DeanSupertramp/Progettazione_Industriale/README.md

# *_Dispositivo per il monitoraggio indoor della qualità ambientale e inoltro dati tramite SMS_*
### Corso di Laurea Magistrale in Ingegneria Elettronica, Corso di Progettazione Industriale, Unical, aa 2020/2021
Il progetto prevede la realizzazione di un dispositivo smart adatto per contesti abitativi, uffici, ospedali, palestre, trasporti, scuole, per monitorare la qualità dell’aria interna e in generale dei parametri ambientali ad esso associata.
Il sistema è basato su diversi sensori e sistemi di notifica (visivo e uditivo, locale e in remoto). Altra funzionalità implementata è la notifica da remoto dello stato ambientale tramite SMS, riportando anche l’eventuale assenza di corrente nella rete elettrica domestica.

## Indice
1. [Schema a blocchi del sistema](#schema-a-blocchi-del-sistema)
2. [Prototipo](#prototipo)
3. [Render 3D del dispositivo](#render-3d-del-dispositivo)
4. [Relazione Tecnica](https://github.com/DeanSupertramp/Progettazione_Industriale/blob/master/Report%20Finale%20Progetto%20-%20Andrea%20Alecce.pdf)
5. [Presentazione](https://github.com/DeanSupertramp/Progettazione_Industriale/blob/master/Presentazione%20Finale%20Progetto%20-%20Andrea%20Alecce.pdf)

## Schema a blocchi del sistema
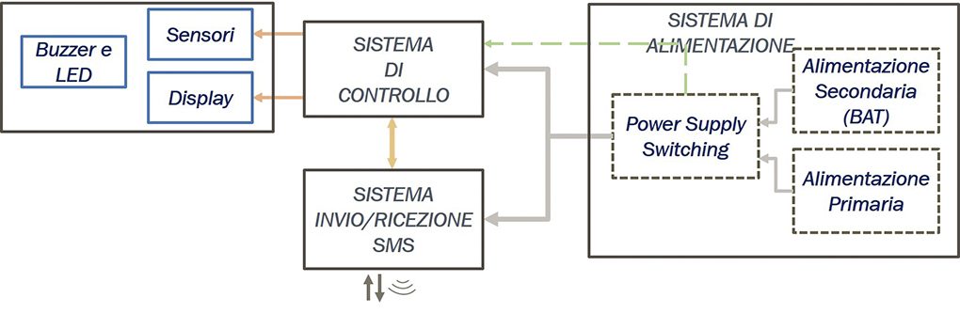
[picture p1: images/blockdiagram.jpg]


## Prototipo
<p align="center">
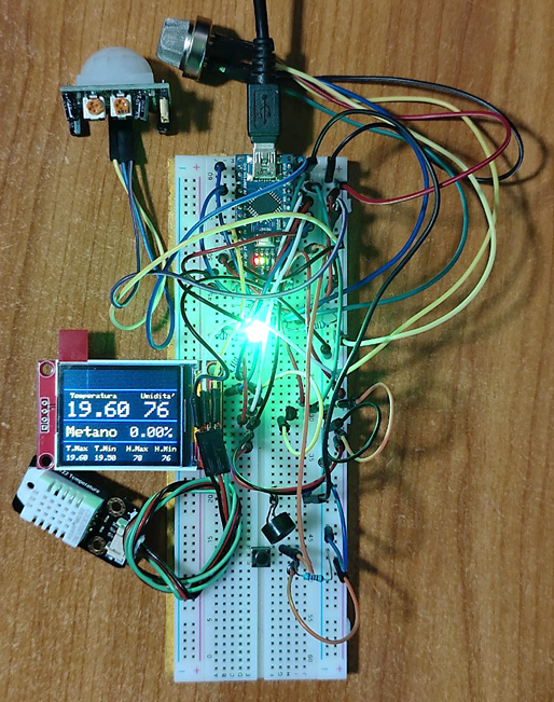
[picture p2: images/prototipo.png]

</p>

## Render 3D del dispositivo
<p align="center">
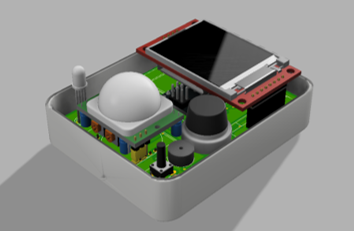
[picture p3: images/render1.png]

</p>

<p align="center">
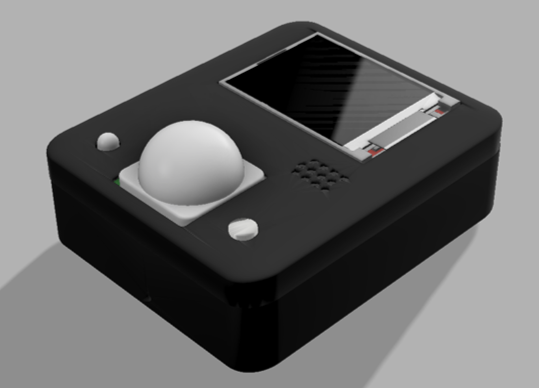
[picture p4: images/render2.png]

</p>
