DeanSupertramp/Progettazione_Industriale/(commit log)

2020-12-13 pin definition ordinata
2020-12-13 moved to NewTone lib, resolved issues with interrupt
    [Display_Sensor.ino, melody.h]
2020-12-13 resolve some interrupt issues
    [Display_Sensor.ino, melody.h]
2020-12-17 create library tools for DHT22 and MQ5 sensors
2020-12-17 add new funcion library for interrupt uses
2020-12-18 fixed some anomalous interrupt behaviour
    [Display_Sensor.ino]
